bakadave/esp8266-dsmr/PCB/esp_dsmr/export/RFQ_221224/esp-dsmr.pdf

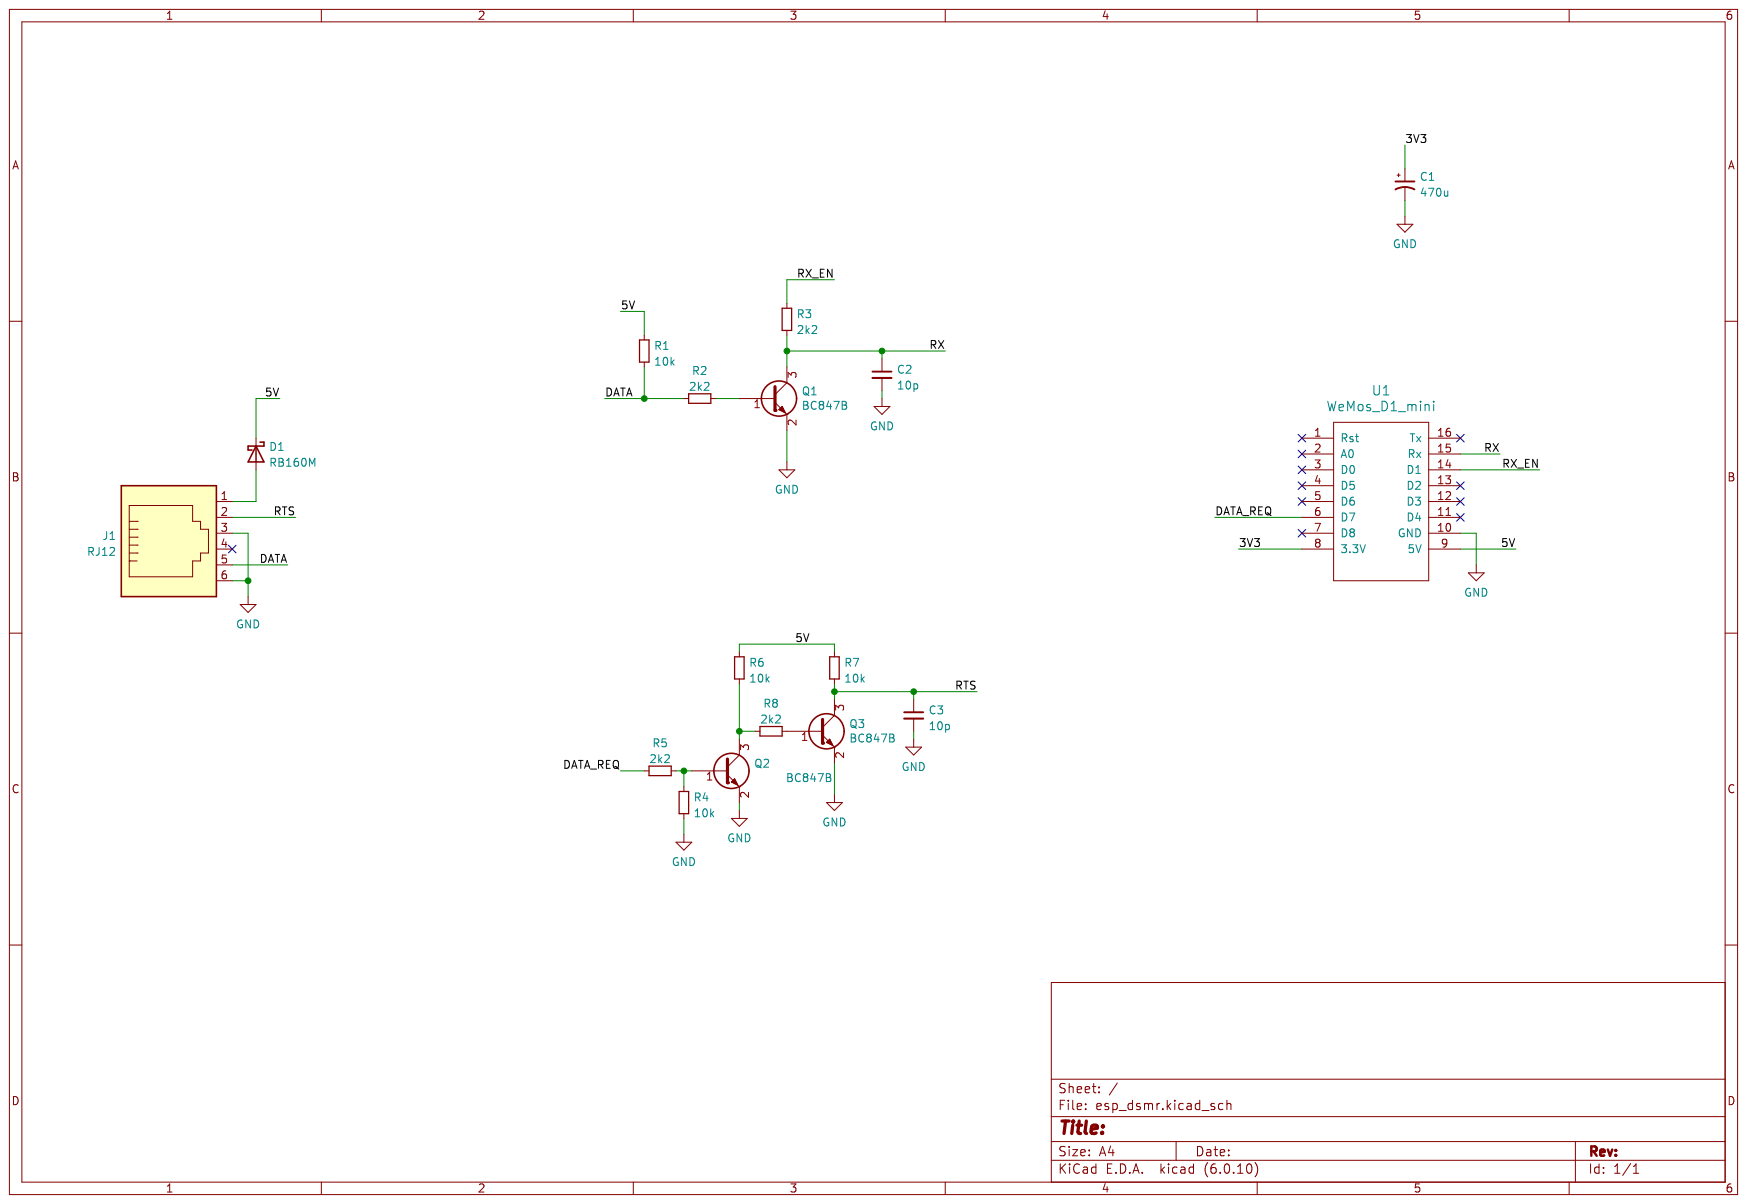
[picture p1: page 1]
