bakadave/esp8266-dsmr/PCB/simulation/DATA_REQ.asc

C1: cap; 470µ
C2: cap; 10p
D1: zener; STZ5_6N
M1: pmos; BSS84
Q1: npn; BC847B
R1: res; 1k
R2: res; 470
R3: res; 0
R4: res; 4k7
R5: res; 1k
R6: res; 10k
U1: PC817D
V1: voltage; 5; Rser=0.5
V2: voltage; PULSE(0 3.3 1m 10u 10u 1m 3m 5)
Named nets: 0, 5V, DATA_REQ
meter circuitry
.tran 5m
