bakadave/esp8266-dsmr/PCB/simulation/UART_invert.asc

C1: cap; 22p
C2: cap; 22p
Q1: npn; BC847B
Q2: npn; BC847B
Q3: npn; BC847B
R1: res; 2k2
R2: res; 10k
R3: res; 2k2
R4: res; 2k2
R5: res; 10k
R6: res; 10k
R12: res; 2k2
V1: voltage; PULSE(5 0 250u 100n 100n 8.6u 25u 5)
V2: voltage; 3V3
V3: voltage; 5
V4: voltage; PULSE(0 3.3 100u 100p 100p 100u)
V5: voltage; 3.3
Named nets: 0, DATA, 5V, RX_EN, DATA_REQ, RTS, RX, 3V3
.tran 1m
