bakadave/esp8266-dsmr/PCB/simulation/UART_invert_2.asc

C1: cap; 10p
C2: cap; 10p
M1: nmos; BSS123
R1: res; 470
R2: res; 1k
R3: res; 1k
U1: PC817D
V1: voltage; PULSE(0 5 500u 1u 1u 500u 1500u 10)
V2: voltage; PULSE(0 3.3 1100u 10u 10u 4m 5m 1)
V3: voltage; 5; Rser=0.5
Named nets: 0, TX, 5V, RX, RX_EN
meter circuitry
.tran 5m
