bakadave/esp8266-dsmr/PCB/esp12E_dsmr/esp12E_dsmr.kicad_pcb

## KiCad design PCB/esp12E_dsmr/esp12E_dsmr.kicad_pcb (2023-01-03)

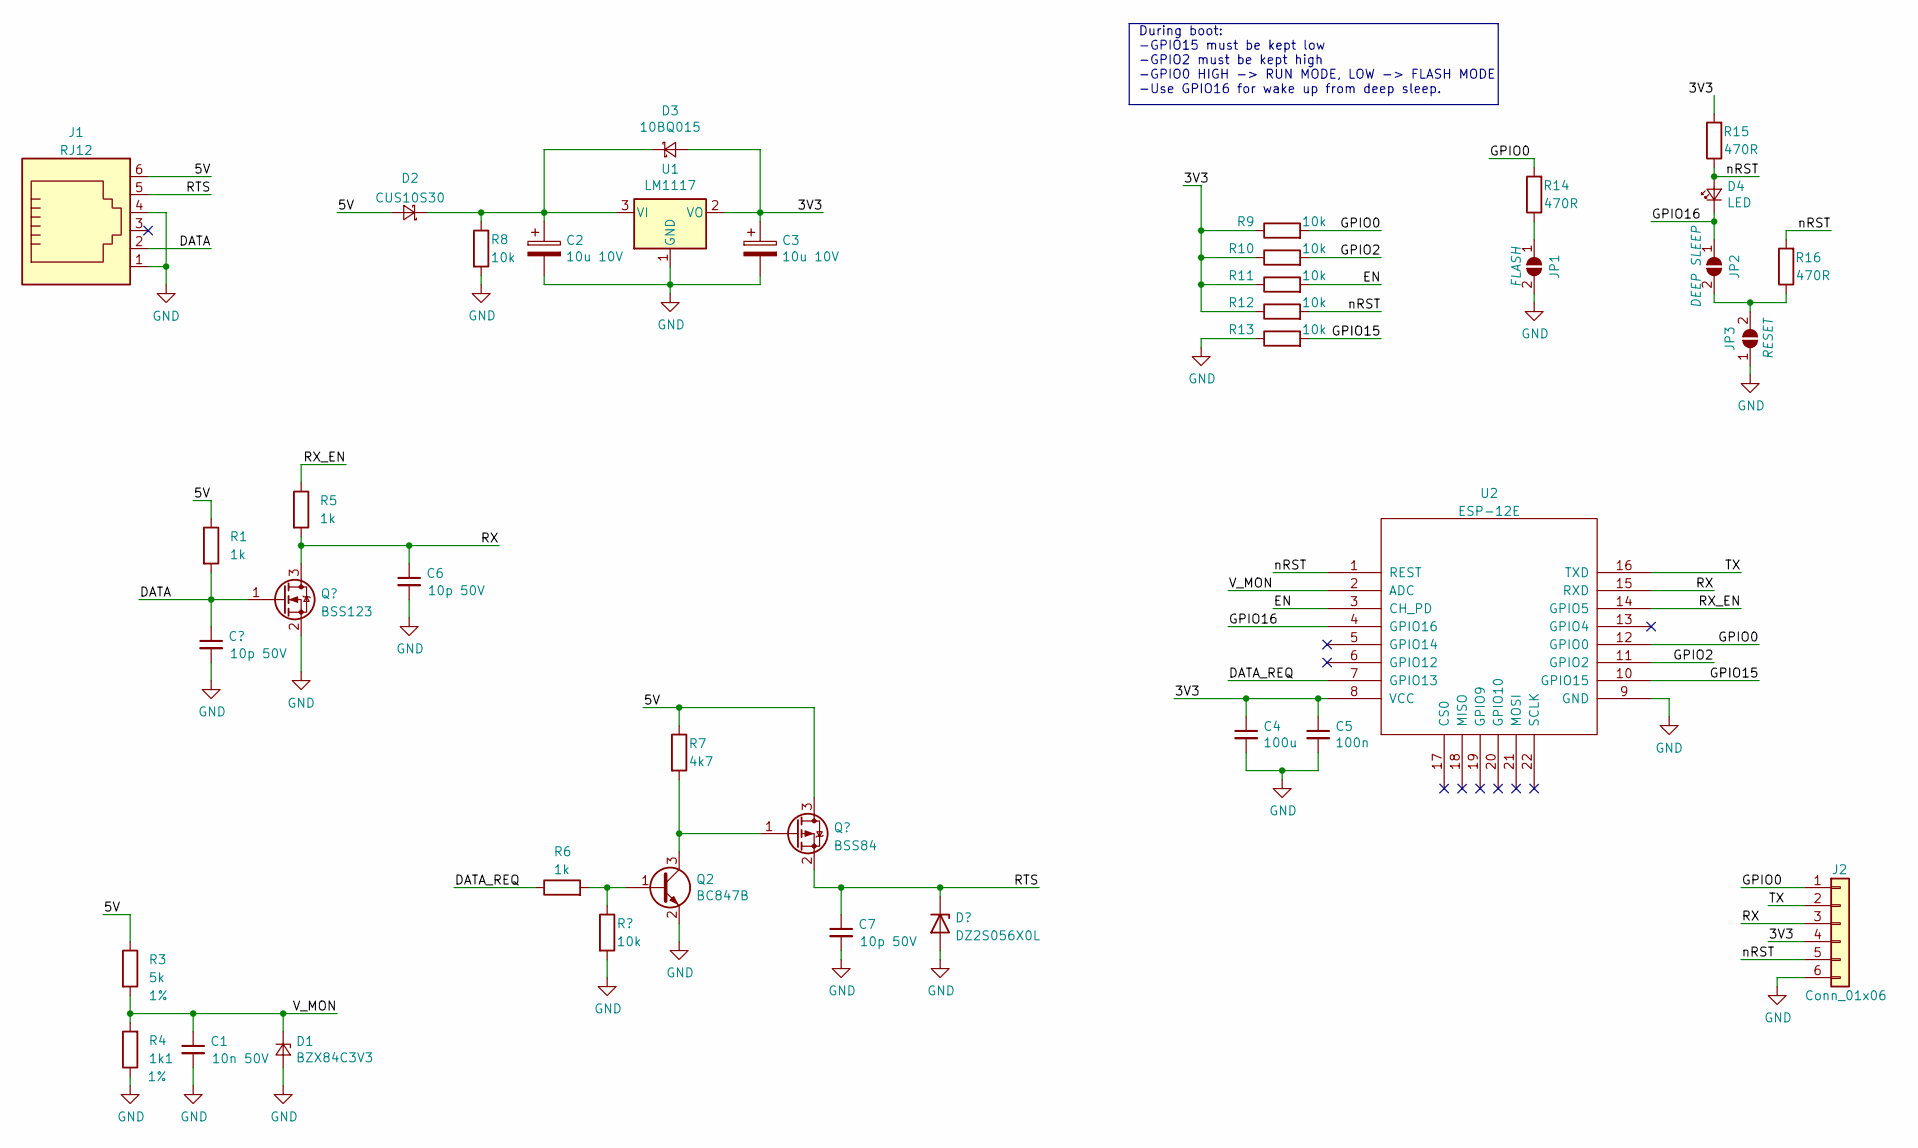
[picture p2: schematic esp12E_dsmr.kicad_sch]

Parts:
C1: 10n 50V; CAP_0805; MPN CC0805JKNPO9BN103; LCSC C527201
C2, C3: 10u 10V; CP_EIA-3216-18_Kemet-A_Pad1.58x1.35mm_HandSolder; MPN T529P106M010AAE200; LCSC C696821
C4: 100u; C_1206_3216Metric; MPN CC1206MKX5R5BB107; LCSC C110048
C5: 100n; CAP_0805; MPN CC0805KRX7R9BB104; LCSC C49678
C6, C7: 10p 50V; CAP_0805; MPN CC0805JRNPOABN100; LCSC C576965
D1: BZX84C3V3; D_SOT-23_ANK; MPN BZX84C3V3LT1G; LCSC C82473
D2: CUS10S30; D_SOD-323_HandSoldering; MPN CUS10S30,H3F; LCSC C146335
D3: 10BQ015; D_SMB; MPN VS-10BQ015-M3/5BT; LCSC C413466
D4: LED; LED_0805; MPN 17-215/BHC-AP1Q2/3T; LCSC C131208
J1: RJ12; RJ25_Wayconn_MJEA-660X1_Horizontal
J2: Conn_01x06; PinHeader_1x06_P2.54mm_Vertical
JP1, JP2, JP3: SolderJumper_2_Open; SolderJumper-2_P1.3mm_Open_TrianglePad1.0x1.5mm
Q2: BC847B; SOT-23; MPN BC847BLT1G; LCSC C94393
R1, R5, R6: 1k; RES_0805; MPN RC0805JR-071KL; LCSC C100046
R3: 5k; RES_0805
R4: 1k1; RES_0805
R7: 4k7; RES_0805
R8, R9, R10, R11, R12, R13: 10k; RES_0805; MPN RC0805JR-0710KL; LCSC C100047
R14, R15, R16: 470R; RES_0805; MPN RC0805JR-07470RL; LCSC C114747
U1: LM1117; SOT-223-3_TabPin2; MPN LM1117IMPX-3.3/NOPB; LCSC C23984
U2: ESP-12E

Connections:
/3V3: C3.1, C4.1, C5.1, D3.2 (A), J2.4, R9.1, R10.1, R11.1, R12.1, R15.2, U1.2 (VO), U2.8 (VCC)
/5V: D2.2 (A), J1.6, R1.1, R3.1, R7.1; also elsewhere on the board
/DATA: J1.2, R1.2; also elsewhere on the board
/DATA_REQ: R6.1, U2.7 (GPIO13)
/EN: R11.2, U2.3 (CH_PD)
/GPIO0: J2.1, R9.2, R14.2, U2.12 (GPIO0)
/GPIO2: R10.2, U2.11 (GPIO2)
/GPIO15: R13.2, U2.10 (GPIO15)
/GPIO16: D4.1 (K), JP2.1 (A), U2.4 (GPIO16)
/RTS: C7.1, J1.5; also elsewhere on the board
/RX: C6.1, J2.3, R5.2, U2.15 (RXD); also elsewhere on the board
/RX_EN: R5.1, U2.14 (GPIO5)
/TX: J2.2, U2.16 (TXD)
/V_MON: C1.1, D1.1 (K), R3.2, R4.2, U2.2 (ADC)
/nRST: D4.2 (A), J2.5, R12.2, R15.1, R16.2, U2.1 (REST)
GND: C1.2, C2.2, C3.2, C4.2, C5.2, C6.2, C7.2, D1.2 (A), J1.1, J1.4, J2.6, JP1.2 (B), JP3.1 (A), Q2.2 (E), R4.1, R8.2, R13.1, U1.1 (GND), U2.9 (GND); also elsewhere on the board
unnamed: C2.1, D2.1 (K), D3.1 (K), R8.1, U1.3 (VI)
unnamed: JP1.1 (A), R14.1
unnamed: JP2.2 (B), JP3.2 (B), R16.1
unnamed: Q2.1 (B), R6.2
unnamed 21: Q2.3 (C), R7.2; also elsewhere on the board

Notes on the sheet:
During boot: -GPIO15 must be kept low -GPIO2 must be kept high -GPIO0 HIGH -> RUN MODE, LOW -> FLASH MODE -Use GPIO16 for wake up from deep sleep.

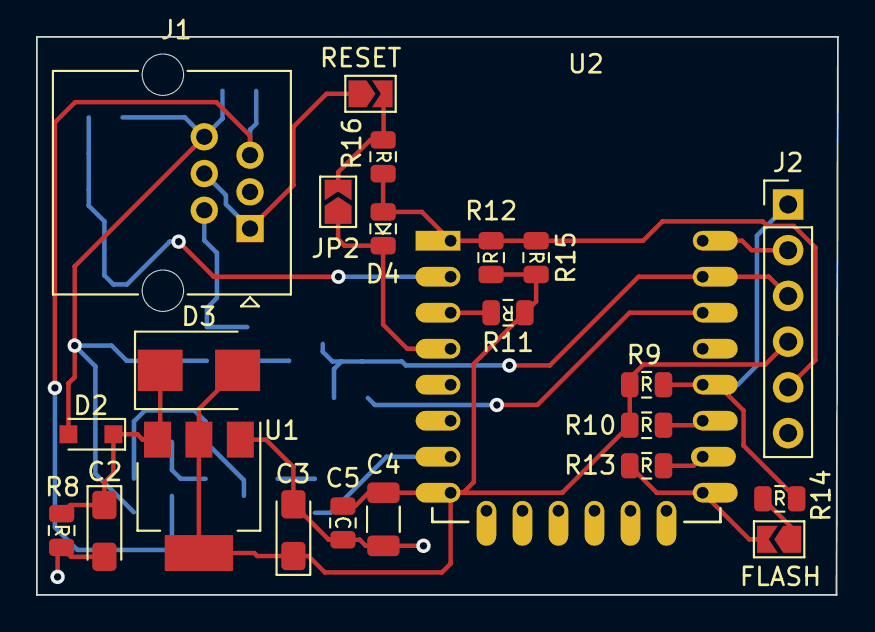
[picture p3: board esp12E_dsmr.kicad_pcb from above]

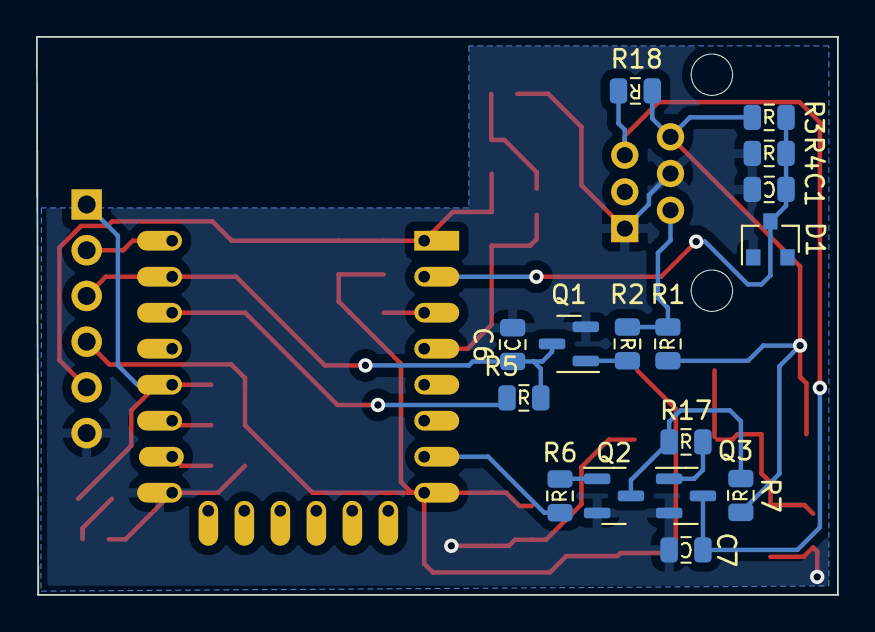
[picture p4: board esp12E_dsmr.kicad_pcb from below]

Board: 2 copper layers, 44.5 x 31.0 mm, 39 parts (16 on the bottom side), 23 nets.

Other parts of the board:
Q1, Q3: BC847B; SOT-23
R2, R17: 2k2; RES_0805
R18: 10k; RES_0805

Their connections:
/5V: R18.1; also elsewhere on the board
/DATA: R2.1; also elsewhere on the board
/RTS: Q3.3 (C), R18.2; also elsewhere on the board
/RX: Q1.3 (C); also elsewhere on the board
GND: Q1.2 (E), Q3.2 (E); also elsewhere on the board
unnamed: Q1.1 (B), R2.2
unnamed 21: R17.1; also elsewhere on the board
unnamed: Q3.1 (B), R17.2
