bakadave/esp8266-dsmr/PCB/esp_dsmr/esp_dsmr.kicad_pcb

## KiCad design PCB/esp_dsmr/esp_dsmr.kicad_pcb (2023-01-03)

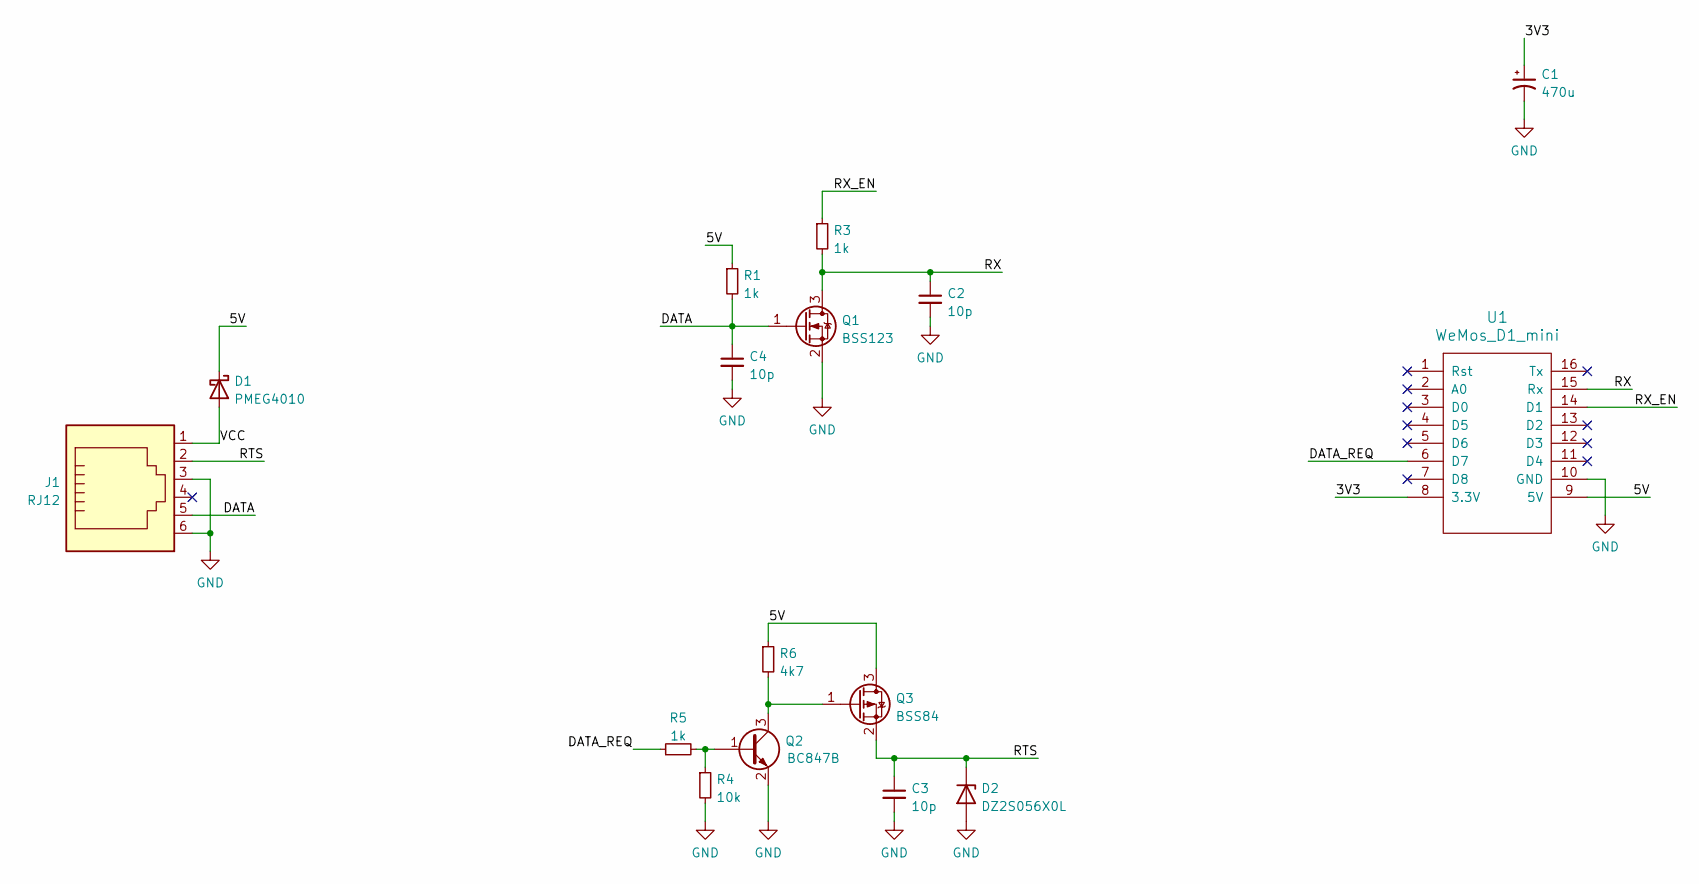
[picture p5: schematic esp_dsmr.kicad_sch]

Parts:
C1: 470u; C_Radial_D8.0mm_H11.5mm_P3.50mm
C2, C3, C4: 10p; CAP_0805
D1: PMEG4010; D_SOD-128; MPN PMEG4010EP,115
D2: DZ2S056X0L; D_SOD-523
J1: RJ12; RJ25_Wayconn_MJEA-660X1_Horizontal
Q1: BSS123; SOT-23
Q2: BC847B; SOT-23; MPN BC847BLT1G; LCSC C94393
Q3: BSS84; SOT-23
R1, R3, R5: 1k; RES_0805
R4: 10k; RES_0805
R6: 4k7; RES_0805
U1: WeMos_D1_mini; WEMOS_D1_mini_light

Connections:
/3V3: C1.1, U1.8 (3.3V)
/5V: D1.1 (K), Q3.3 (D), R1.1, R6.1, U1.9 (5V)
/DATA: C4.1, J1.5, Q1.1 (G), R1.2
/DATA_REQ: R5.1, U1.6 (D7)
/RTS: C3.1, D2.1 (K), J1.2, Q3.2 (S)
/RX: C2.1, Q1.3 (D), R3.2, U1.15 (Rx)
/RX_EN: R3.1, U1.14 (D1)
/VCC: D1.2 (A), J1.1
GND: C1.2, C2.2, C3.2, C4.2, D2.2 (A), J1.3, J1.6, Q1.2 (S), Q2.2 (E), R4.2, U1.10 (GND)
unnamed: Q2.1 (B), R4.1, R5.2
unnamed: Q2.3 (C), Q3.1 (G), R6.2

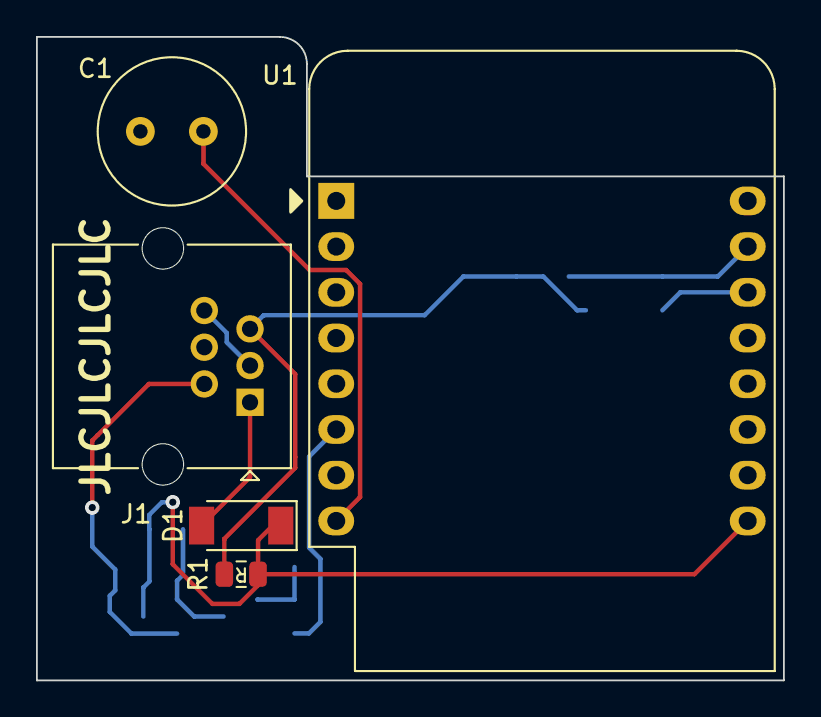
[picture p6: board esp_dsmr.kicad_pcb from above]

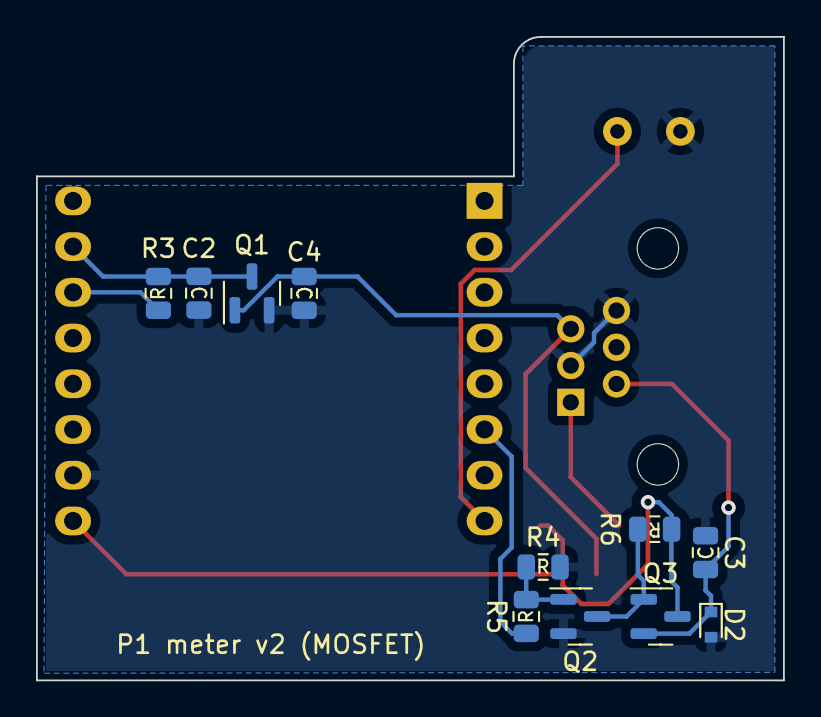
[picture p7: board esp_dsmr.kicad_pcb from below]

Board: 2 copper layers, 41.5 x 35.8 mm, 16 parts (11 on the bottom side), 11 nets.
